asmnoak/SI4732_allwave_radio_controlled_by_pi_pico/schematic2.pdf

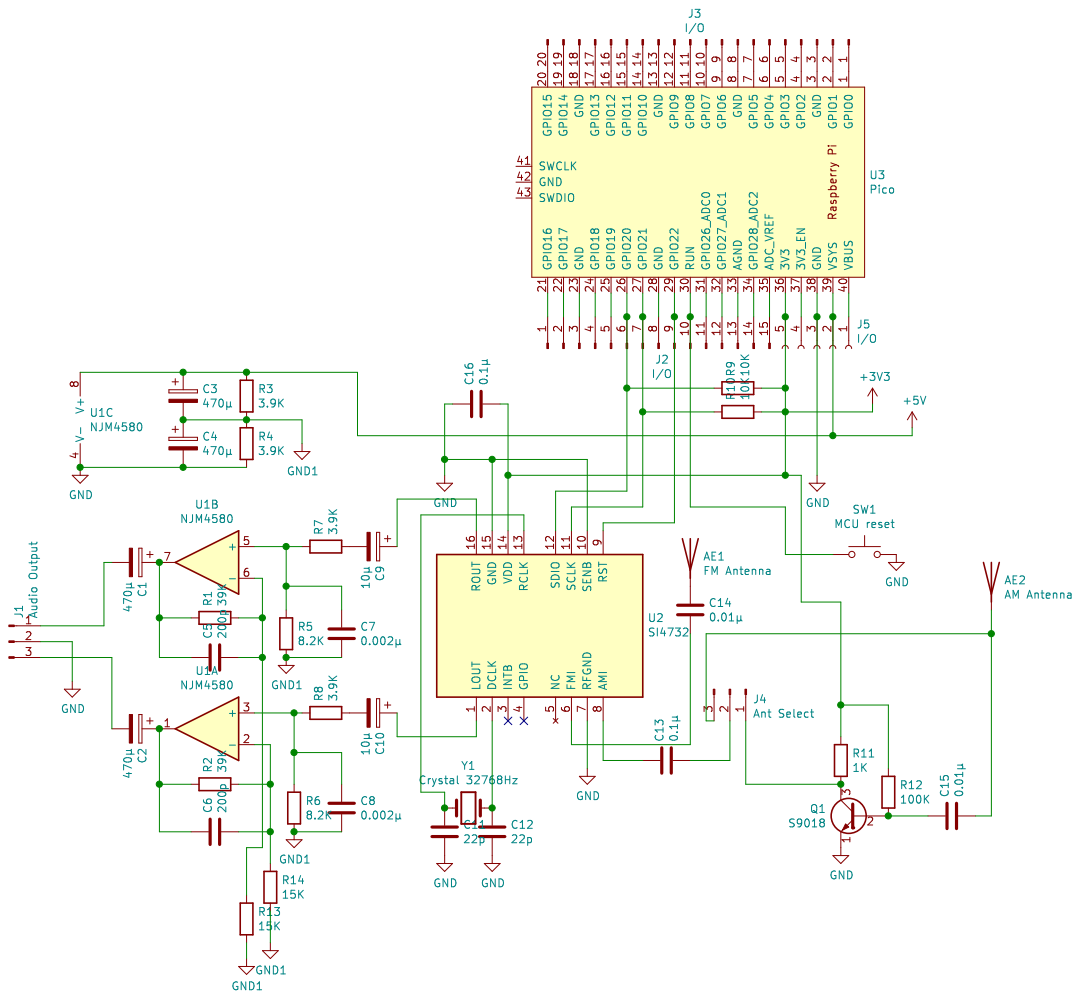
[picture p3: page 1]
